pupplet1999/voice-trainer/README.md

# Welcome to the Voice Trainer! 

This is a wearable device designed to monitor vocal frequency and provide haptic feedback when your pitch goes too low! It is built around bone-conduction sensing, the YIN pitch-tracking algorithm, and an ESP32-S3 microcontroller.

---

## Features
**Bone Conducting Microphone:** This project utilizes an awesome little bone conducting microphone (VMM-1627L-R) so that we can completely eliminate ambient noise.

**Low-Latency Pitch Tracking:** This project implements the autocorrelation-based YIN algorithm on the ESP32-S3 so it's pretty quick :) It has plenty of power to run this program but I have yet to see if it gets too hot :'(

**Haptic Feedback:** With the addition of a DRV2605L motor driver and the little coin motor with it, it can generate a variety of haptic feedback signals. If you want to customize it further to make different vibrations when you fall below the pitch you want, please see the customization section.

---

## Bill of Materials

 **SparkFun ESP32-S3 Thing Plus**: Really any ESP32-S3 that has USB-C, LiPo JST-PH 2.0mm with onboard charging, STEMMA-QT connector

 **VMM-1627L-R**  MEMS bone-conduction microphone capsule | Analog OUT, VDD, GND |
 https://www.digikey.com/en/products/detail/pui-audio-inc/VMM-1627L-R/17085367

 **MAX4466 Breakout**  Preamplifier with adjustable gain  Analog IN/OUT (Neck Node) 

 **Adafruit DRV2605L**  Haptic motor driver  I2C (Qwiic / STEMMA QT) 

 **ERM Coin Vibration Motor**  Tactile feedback actuator  Connected to DRV2605L. Also from Adafruit.

 **1100 mAh 1S LiPo Battery**  3.7V power cell w/ JST-PH 2.0mm (2-pin) 

 **30 AWG Magnet / Silicone Wire**  Used to connecte everything together.

 **Soldering Flux** This is a must.

**Solder** Need some to connect it all together haha.

**3-Prong Switch** Thats just what I ended up using but it doesn't really matter. Just needs to turn on and off!

**Heat shrink wrapping** Make sure to not get any short circuits

---
## Tools Required

**3D Printer** Any printer should do. Just have some PLA or PETG around.

**Soldering Iron** I recommend a high quality soldering station and some helping hands to hold everything together.

**Wire Strippers/Clippers** 

**Heat gun/Hair dryer** For heat shrink wrap

---

## Disclaimers
I am not an expert just a girl frustrated with not remembering to use my voice. I am also not very good at soldering nor an electrical engineer. If I can make this, so can you!

## Hardware Modifications & Wiring

### 1. Prepare the VMM-1627L-R
...
The image shows the mic wired up on the MAX4466 amplifier:

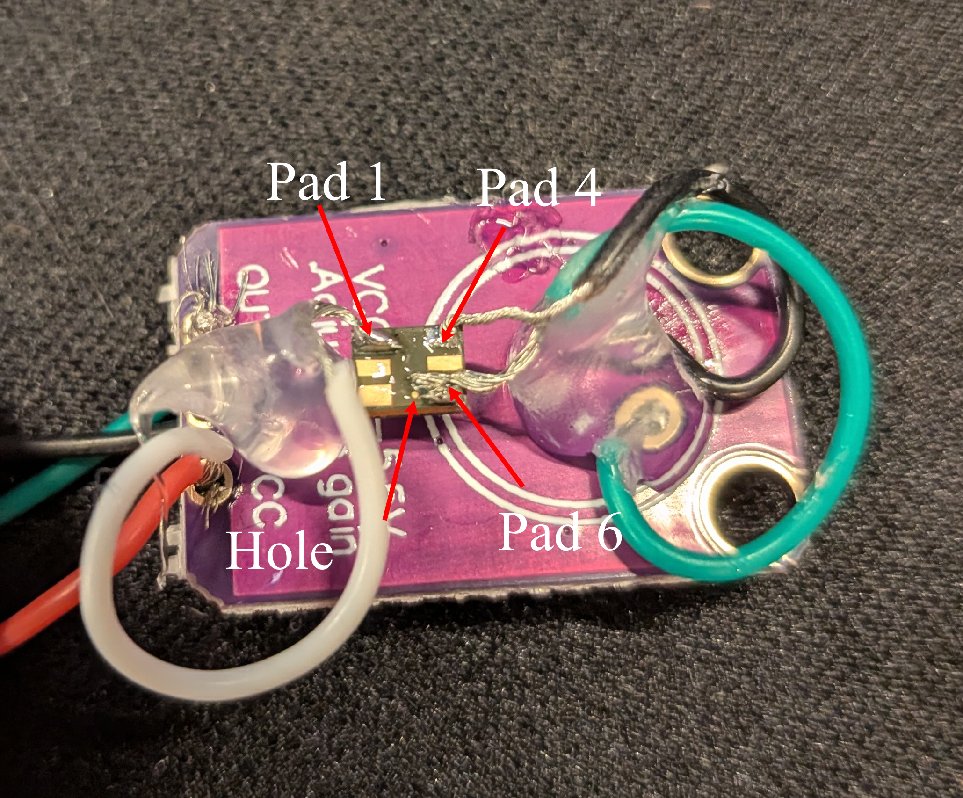
[picture p1: images/MAX4466_MIC_TOP.jpg]
MAXX4466 with mic


After the pads are soldered on, make sure to secure it in place with some super glue or hot glue.
...

### 2. MAX4466 Preamplifier Modification
Stock MAX4466 breakout boards include a pull-up bias resistor designed for 2-pin electret capsules. Because the VMM-1627L-R is an active 3-pin MEMS microphone with its own internal buffer, the DC bias resistor must be removed:
- **Remove electret microphone:** Desolder the microphone + and - pins and pop it out!
- **Remove Resistor R1:** Desolder or cut R1 connected to the positive input pad to decouple DC power from the audio input line.

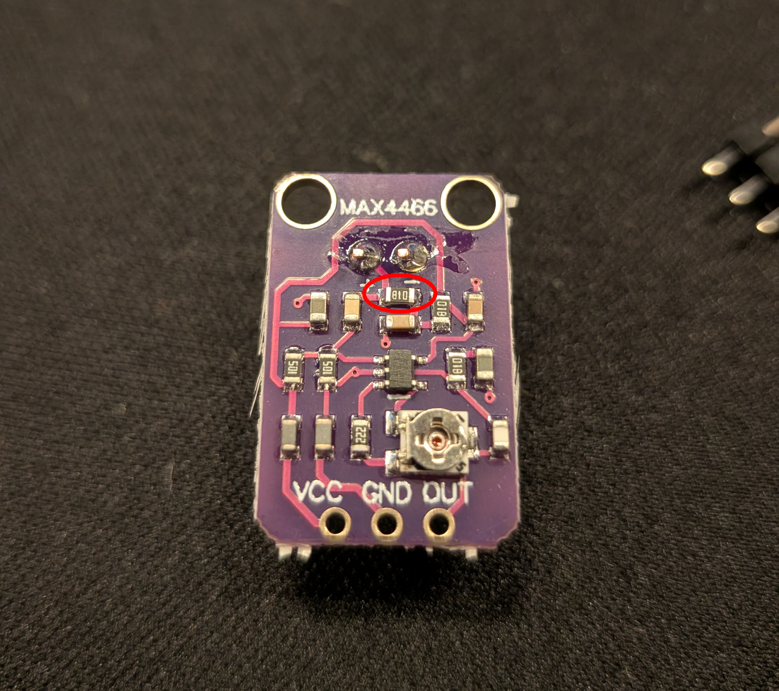
[picture p2: images/MAX4466.jpg]
MAX4466 Intact


It is easier to remove if you put a glob of solder on the tip and then cover it to remove it.
- **Solder on the VMM-1626L-R:** 

Its time to connect the VMM-1627L-R to the amplifier since it is ready!
We will solder the VMM OUT to the positive (+) and the VMM GND to negative (-). VMM power (VDD) will be hooked right up to the breakout board VCC.

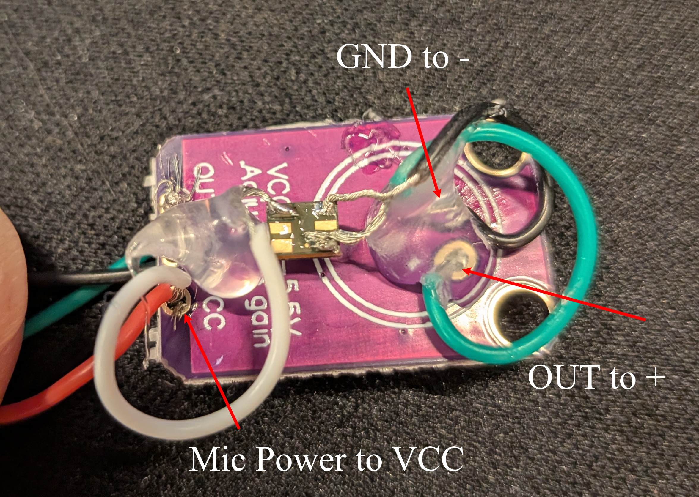
[picture p3: images/MAX4466_TOP_PINOUT.jpg]
MAX4466 pinout


### 3. Battery Modification and Polarity Check
...
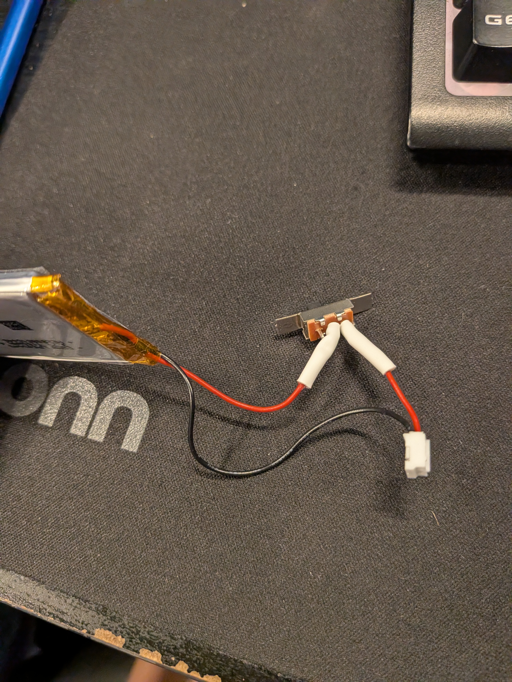
[picture p4: images/BATTERY_MOD.jpg]
Battery Modification


### 4. Haptic Motor Driver and Coin Motor Assembly
This is thankfully very easy. Simply solder the red wire to the + and blue wire to the - on the DRV2605L board.

| Component Front | Component Back |
| :---: | :---: |
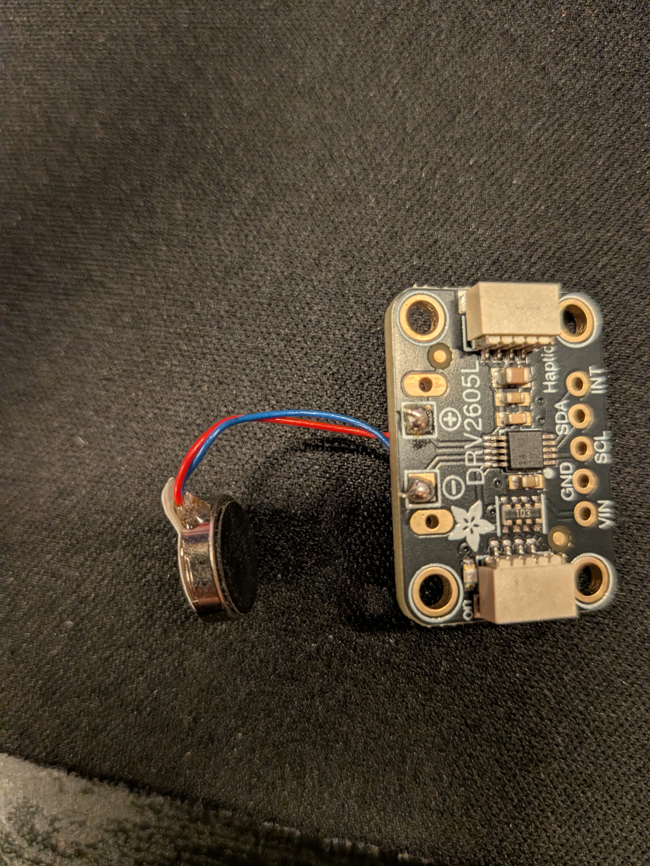
[picture p5: images/DRIVER_FRONT.jpg]
DRV2605L Front
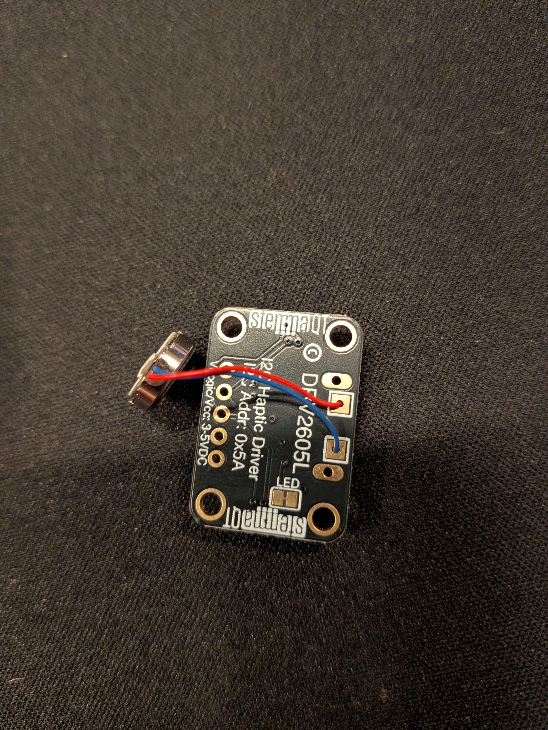
[picture p6: images/DRIVER_BACK.jpg]
DRV2605L Back
|  |  |

### 5. Final Assembly
Time to put it all together! Place the bone conducting mic/amplifier combo into the neck box. Thread the three wires through the hole in the side and then solder them into the pins on the ESP32. 

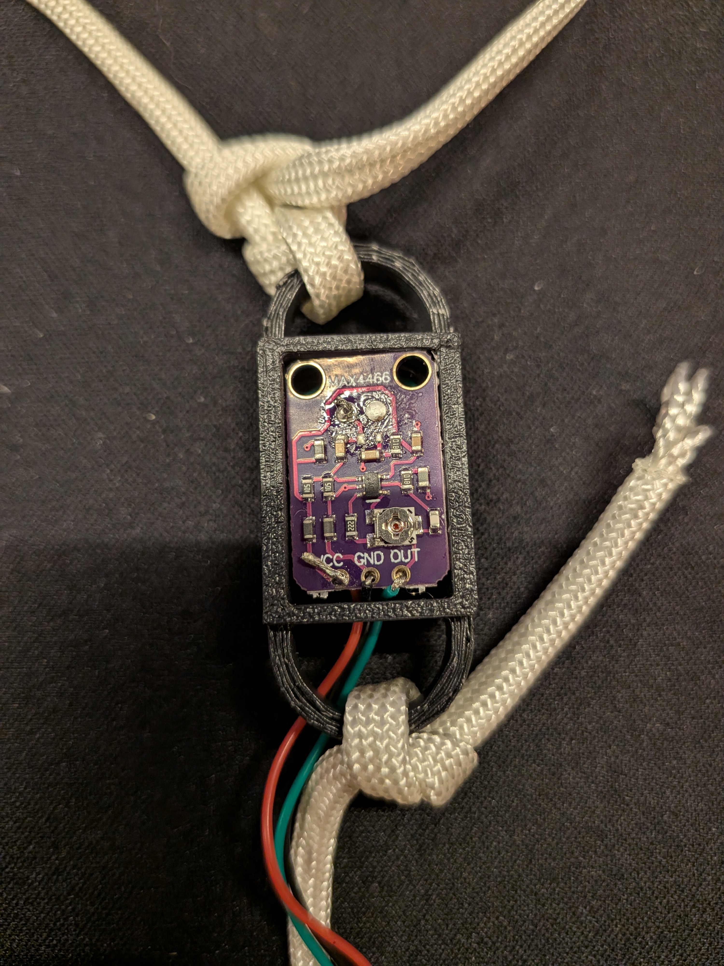
[picture p7: images/MIC_IN_CASE.jpg]
Mic Assembly


You will put power wire (red) to the 3.3v pin, ground (black) to GND, and the analog output (green) to pin 14.

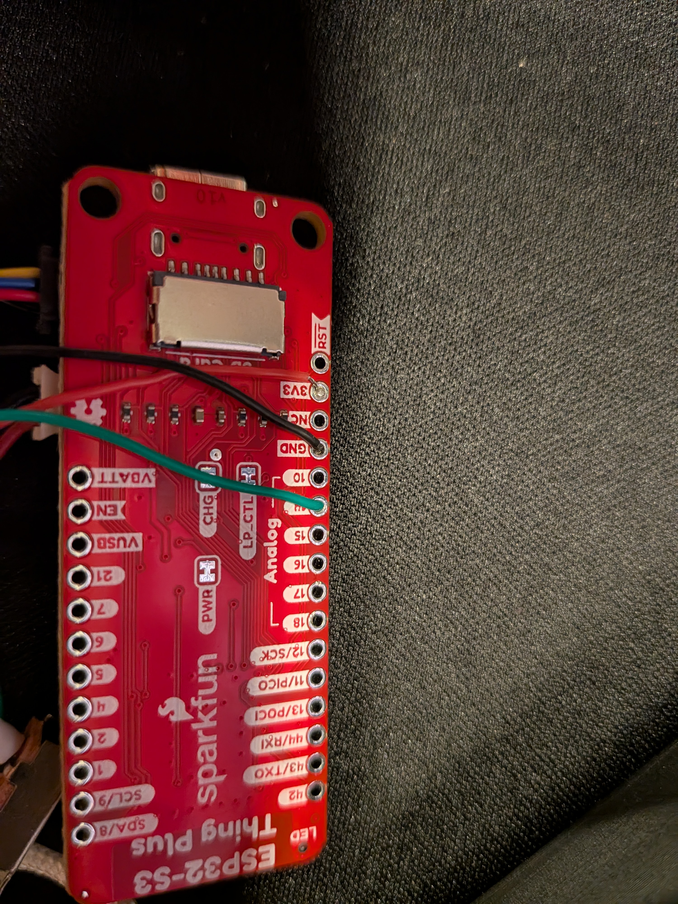
[picture p8: images/WIRING_PINOUT.jpg]
Wiring


Lastly, plug in everything you need! STEMMA QT and battery connectors to each part.

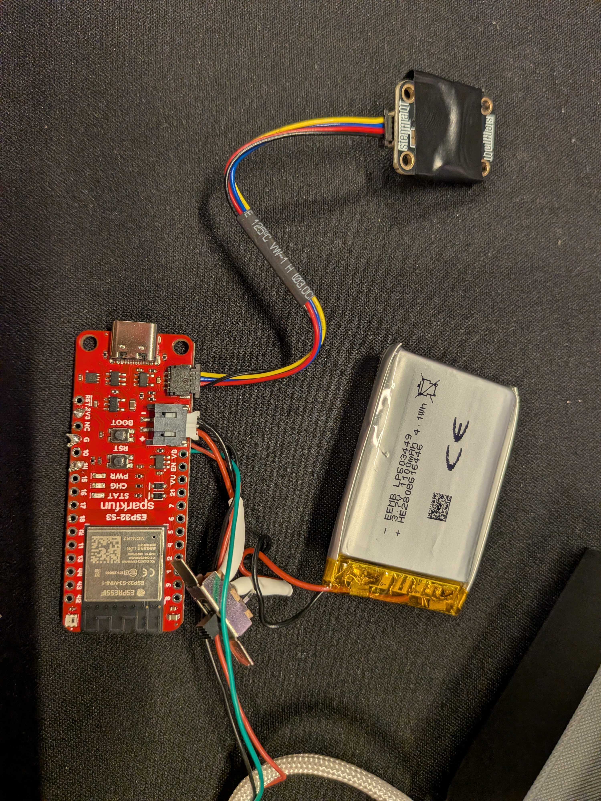
[picture p9: images/WIRING_COMPLETE.jpg]
Connected Cables


After all of this, it is time to throw it all into a case. I have a **VERY** rough 3D printed case so far but it works. I wouldn't be caught dead wearing it in public though :'(

Check out the 3D models for the case.

## Customization

### 1. Changing the Pitch Threshold

In order to adjust the pitch you want it to activate at, simply open up the arduino IDE and change line 12:

#define PITCH_THRESHOLD_HZ 175.0f

I just chose 175 because it is a bit lower than a female average minimum.

### 2. Changing the Haptic Feedback

To change the haptic feedback, Just change the number for the WAVEFORM on line 27.

#define WAVEFORM 47

 47 is the number for the strong buzz. Other interesting candidates could be 1 or 12. A click or triple click. Look up the library for various different haptic effects. There are many!

### 3. Make your own pretty case! <3

The current case design is a bit bland.

## Future Plans

### 1. Custom PCB for Mic/Amp

I think that this project would benefit greatly from a custom PCB, but I am sadly not an electrical engineer. While the MAX4466 schematics and board are publically avaliable on the Adafruit website, I have yet to create a modified version of the amplifier board that includes a VMM-1627L-R instead of an electret microphone as well as remove the pull-up resistor. Sadly these things both cost time and money.

### 2. Bluetooth/Phone integration

It would be nice for anyone who wants to change some setting on the fly to be able to. Maybe allow the pitch to be changed and the haptic feedback. I could also integrate data-tracking so you can follow your vocal pitch throughout the day. This is pretty low on the list of things I want done want the main functions to be rock-solid.
