pupplet1999/voice-trainer/images/BATTERY_CONNECTED.jpg

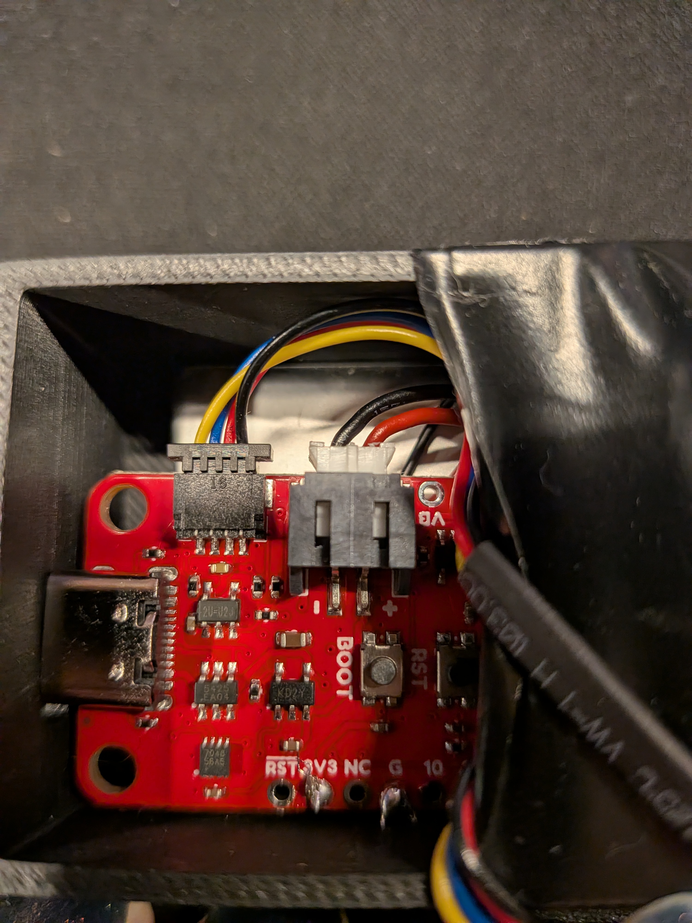
images/BATTERY_CONNECTED.jpg
