pupplet1999/voice-trainer/images/MAX4466_MIC_BOTTOM.jpg

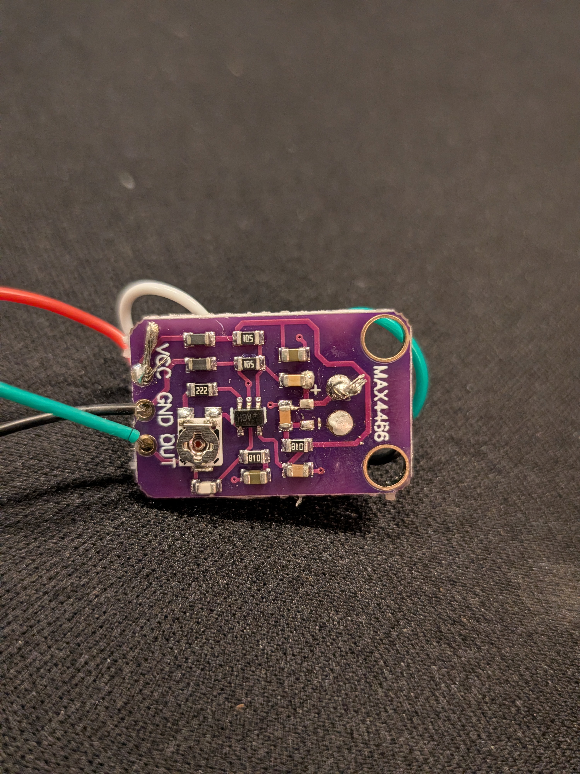
images/MAX4466_MIC_BOTTOM.jpg
