pupplet1999/voice-trainer/images/MAX4466_MIC_SIDE.jpg

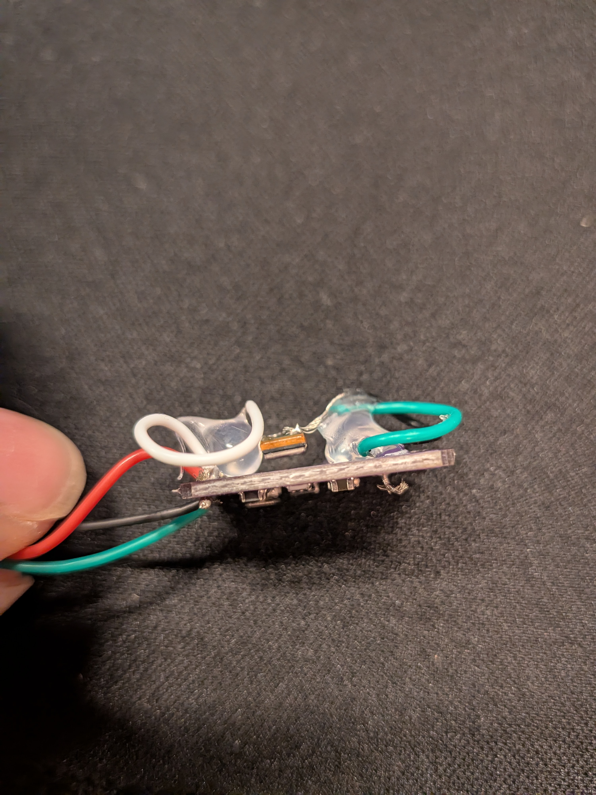
images/MAX4466_MIC_SIDE.jpg
