pupplet1999/voice-trainer/pcb/neck_node/production/bom.csv

Designator | Footprint | Quantity | Value | LCSC Part #
CBIAS1 | 0603 | 1 | 4.7 uF
CDECOUPLING1, CDECOUPLING2 | 0603 | 2 | 0.1 uF
CIN1 | 0603 | 1 | 1uF
J1 | JST_SH_SM03B-SRSS-TB_1x03-1MP_P1.00mm_Horizontal | 1 | Conn_01x03_Socket
MK1 | MIC_VMM-1627L-R | 1 | VMM-1627L-R
R1, R2, RIN1 | 0603 | 3 | 100k
RFEEDBACK1 | 0603 | 1 | 20k
RGND1 | 0603 | 1 | 1k
U1 | SOT-23-6_Handsoldering | 1 | OPA320SAIDBVR
