pupplet1999/voice-trainer/hardware/cad/Pendant_Lid_v3.stl

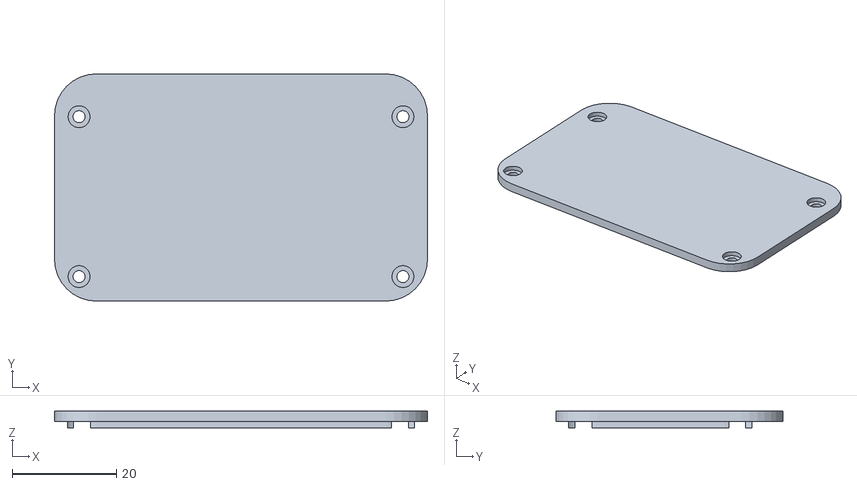
[picture p13: CAD file, 2026-10-16]
hardware/cad/Pendant_Lid_v3.stl
71.4 x 43.5 x 3.20
