pupplet1999/voice-trainer/pcb/neck_node/OPA320SAIDBVR/DBV0006A.stl

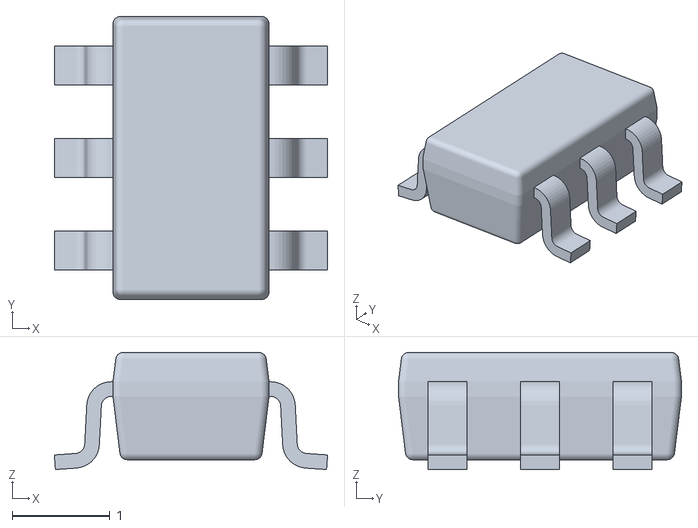
[picture p14: CAD file, 2026-10-19]
pcb/neck_node/OPA320SAIDBVR/DBV0006A.stl
2.80 x 2.90 x 1.20
