pupplet1999/voice-trainer/pcb/neck_node/VMM_1627L_R/VMM-1627L-R.step

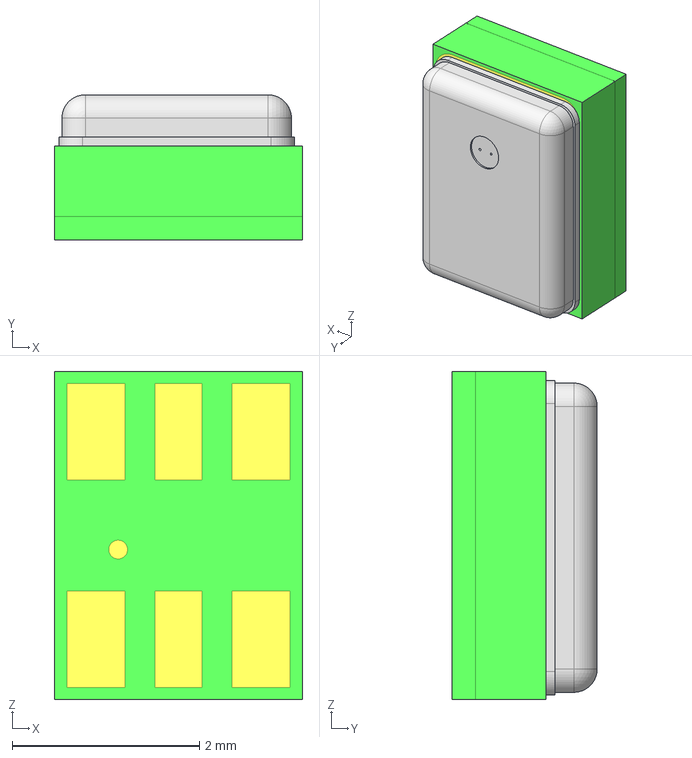
[picture p15: CAD file, 2026-10-19]
pcb/neck_node/VMM_1627L_R/VMM-1627L-R.step
2.65 x 1.55 x 3.50 mm
