pupplet1999/voice-trainer/pendant_box_v3.FCStd

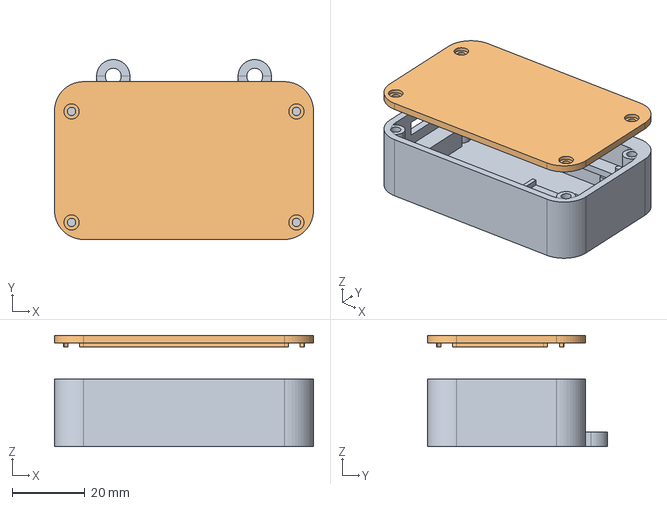
[picture p16: CAD file, 2026-10-16]
pendant_box_v3.FCStd
71.4 x 49.6 x 30.6 mm
Pendant_Base_v2_3
Pendant_Lid_v2_3
