pupplet1999/voice-trainer/hardware/cad/Pendant_Base_v3.stl

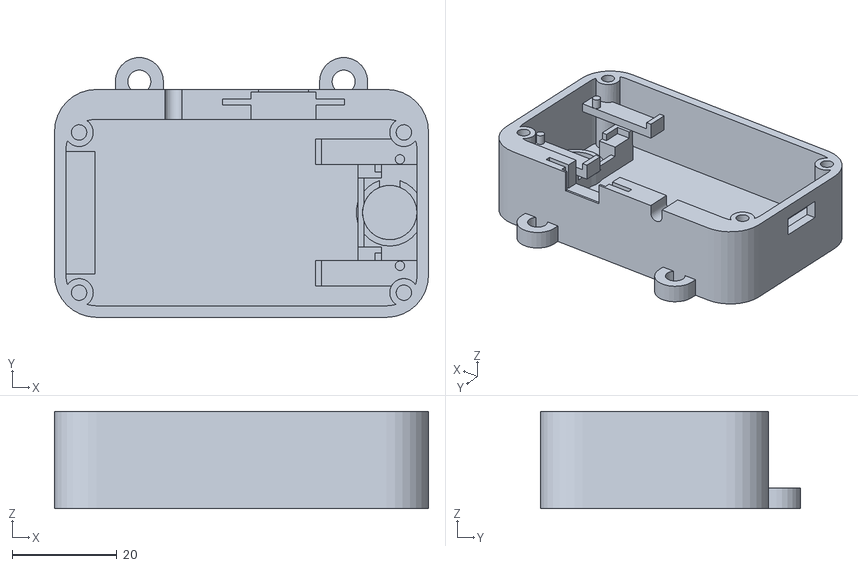
[picture p17: CAD file, 2026-10-16]
hardware/cad/Pendant_Base_v3.stl
71.4 x 49.6 x 18.6
