pupplet1999/voice-trainer/(list of files, cad)

Other CAD files:
pendant_box_v3.3mf
