pupplet1999/voice-trainer/(list of files, drawings)

Other design files:
pcb/neck_node/temp-freerouting.dsn
