pupplet1999/voice-trainer/(commit log)

2026-10-16 Initial commit: hardware CAD models, firmware, and documentation
2026-10-19 Add custom KiCad PCB project for neck node
2026-10-20 Updated README.md to note that custom PCB is added
